SirJuanGod/Matlab-Car-Control-/graphify-out/2026-10-24/GRAPH_REPORT.md

# Graph Report - Car_Control  (2026-10-18)

## Corpus Check
- 13 files · ~40,171 words
- Verdict: corpus is large enough that graph structure adds value.
- Unclassified: 36 file(s) not represented in the graph (top: .mat 26, .l 6, .bak 1)

## Summary
- 67 nodes · 71 edges · 8 communities (6 shown, 2 thin omitted)
- Extraction: 100% EXTRACTED · 0% INFERRED · 0% AMBIGUOUS
- Token cost: 0 input · 0 output

## Community Hubs (Navigation)
- Estrategias de Control: Compuerta (PID, LQR, H-infinita) y Carro Independiente
- 1. Modelo Matemático del Lazo Angular de la Compuerta (canal PWM → θ)
- CLAUDE.md
- Especificaciones del Carro (Plataforma Móvil con IMU y Control Independiente)
- Especificaciones de la Compuerta (Planta Pasiva y Sensor Directo 0-3.3V con ESP32)
- Especificaciones del Ventilador y Etapa de Potencia L298N (24V)
- Arquitectura del Sistema de Control Angular y Plataforma Móvil

## God Nodes (most connected - your core abstractions)
1. `Especificaciones del Carro (Plataforma Móvil con IMU y Control Independiente)` - 9 edges
2. `Estrategias de Control: Compuerta (PID, LQR, H-infinita) y Carro Independiente` - 9 edges
3. `Especificaciones del Ventilador y Etapa de Potencia L298N (24V)` - 8 edges
4. `Arquitectura del Sistema de Control Angular y Plataforma Móvil` - 7 edges
5. `Especificaciones de la Compuerta (Planta Pasiva y Sensor Directo 0-3.3V con ESP32)` - 7 edges
6. `1. Modelo Matemático del Lazo Angular de la Compuerta (canal PWM → θ)` - 5 edges
7. `2. Sensor de Salida: Potenciómetro Directo (0V - 3.3V $\to$ 0° - 180°)` - 4 edges
8. `3. Estrategia 2: Control Óptimo LQR con Acción Integral ($LQR+I$)` - 4 edges
9. `2. Estimación de Distancia Avanzada / Retrocedida con la IMU` - 3 edges
10. `4. Etapa de Potencia: Módulo Puente H L298N a 24 VDC` - 3 edges

## Surprising Connections (you probably didn't know these)
- None detected - all connections are within the same source files.

## Communities (8 total, 2 thin omitted)

### Community 0 - "Estrategias de Control: Compuerta (PID, LQR, H-infinita) y Carro Independiente"
Cohesion: 0.12
Nodes (16): 2.1 Componentes de Implementación, 2. Estrategia 1: Control PID de la Compuerta con Feedforward y Anti-Windup, 3.1 Espacio de Estados Aumentado, 3.2 Optimización Cuadrática, 3.3 Extensión a Dos Salidas del Controlador (SIMO: $u_{PWM}$ y $d_{ref}$), 3. Estrategia 2: Control Óptimo LQR con Acción Integral ($LQR+I$), 4.1 Incertidumbre Paramétrica por Movimiento del Carro, 4.2 Sensibilidad Mixta ($S/KS/T$) (+8 more)

### Community 1 - "1. Modelo Matemático del Lazo Angular de la Compuerta (canal PWM → θ)"
Cohesion: 0.40
Nodes (5): 1.1 Función de Conversión Directa del Potenciómetro, 1.2 Ecuación Dinámica No Lineal, 1.3 Punto de Operación y Equilibrio ($\theta_{eq}$), 1.4 Modelo Linealizado (Pequeña Señal), 1. Modelo Matemático del Lazo Angular de la Compuerta (canal PWM → θ)

### Community 5 - "Especificaciones del Carro (Plataforma Móvil con IMU y Control Independiente)"
Cohesion: 0.18
Nodes (11): 1. Rol en el Proyecto y Condiciones Iniciales, 2.1 Principio Cinemático, 2.2 Observador de Estados / Filtro de Kalman, 2. Estimación de Distancia Avanzada / Retrocedida con la IMU, 3. Parámetros Físicos y Geométricos del Vehículo, 4. Motorreductores DC (Modelo TGP01D-A130), 5. Electrónica del Sistema del Carro, 6. Lazo de Control de Posición Longitudinal del Carro (+3 more)

### Community 6 - "Especificaciones de la Compuerta (Planta Pasiva y Sensor Directo 0-3.3V con ESP32)"
Cohesion: 0.18
Nodes (11): 1. Naturaleza del Sistema Dinámico, 2.1 Calibración Tensión vs. Ángulo (0V a 3.3V), 2.2 Función de Transferencia Directa del Sensor, 2.3 Adquisición Directa con ADC de 12 Bits del ESP32, 2. Sensor de Salida: Potenciómetro Directo (0V - 3.3V $\to$ 0° - 180°), 3. Parámetros Físicos y Mecánicos, 4. Ecuación Dinámica Pasiva de la Compuerta, Enlaces del Grafo (+3 more)

### Community 7 - "Especificaciones del Ventilador y Etapa de Potencia L298N (24V)"
Cohesion: 0.20
Nodes (10): 1. Rol en la Arquitectura de Control, 2. Parámetros de Identificación del Ventilador, 3. Parámetros Eléctricos y Desempeño, 4.1 Configuración de Hardware Crítica del L298N, 4.2 Lógica de Control desde el ESP32, 4. Etapa de Potencia: Módulo Puente H L298N a 24 VDC, 5. Dinámica del Actuador Aerodinámico, Enlaces del Grafo (+2 more)

### Community 8 - "Arquitectura del Sistema de Control Angular y Plataforma Móvil"
Cohesion: 0.29
Nodes (7): 1.1 Estructura SIMO del Controlador (Planta MISO), 1. Descripción General de la Arquitectura, 2. Diagrama de Bloques de los Lazos Internos, 3. Especificaciones Clave de las Interfaces, Arquitectura del Sistema de Control Angular y Plataforma Móvil, Enlaces del Grafo, Etiquetas

## Knowledge Gaps
- **2 thin communities (<3 nodes) omitted from report** — run `graphify query` to explore isolated nodes.

## Suggested Questions
_Questions this graph is uniquely positioned to answer:_

- **Why does `Estrategias de Control: Compuerta (PID, LQR, H-infinita) y Carro Independiente` connect `Estrategias de Control: Compuerta (PID, LQR, H-infinita) y Carro Independiente` to `arquitectura_sistema.md`, `1. Modelo Matemático del Lazo Angular de la Compuerta (canal PWM → θ)`?**
  _High betweenness centrality (0.488) - this node is a cross-community bridge._
- **Should `Estrategias de Control: Compuerta (PID, LQR, H-infinita) y Carro Independiente` be split into smaller, more focused modules?**
  _Cohesion score 0.125 - nodes in this community are weakly interconnected._
- **Why does `Especificaciones del Carro (Plataforma Móvil con IMU y Control Independiente)` connect `Especificaciones del Carro (Plataforma Móvil con IMU y Control Independiente)` to `arquitectura_sistema.md`?**
  _High betweenness centrality (0.271) - this node is a cross-community bridge._
- **Why does `Especificaciones de la Compuerta (Planta Pasiva y Sensor Directo 0-3.3V con ESP32)` connect `Especificaciones de la Compuerta (Planta Pasiva y Sensor Directo 0-3.3V con ESP32)` to `arquitectura_sistema.md`?**
  _High betweenness centrality (0.268) - this node is a cross-community bridge._
