SirJuanGod/Matlab-Car-Control-/code/MATLAB/Outputs/preview/antes_root.png

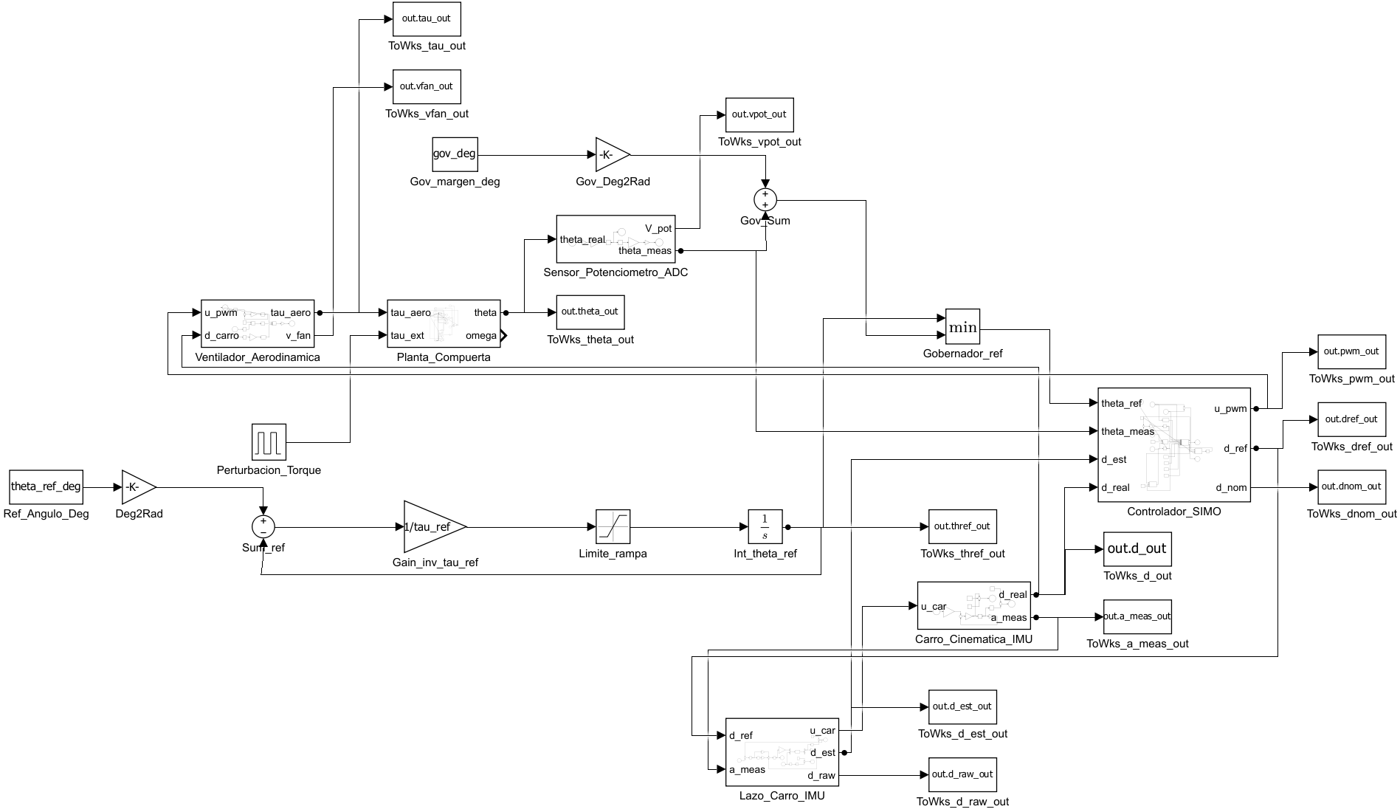
code/MATLAB/Outputs/preview/antes_root.png
