SirJuanGod/Matlab-Car-Control-/code/MATLAB/Outputs/preview/v1_root.png

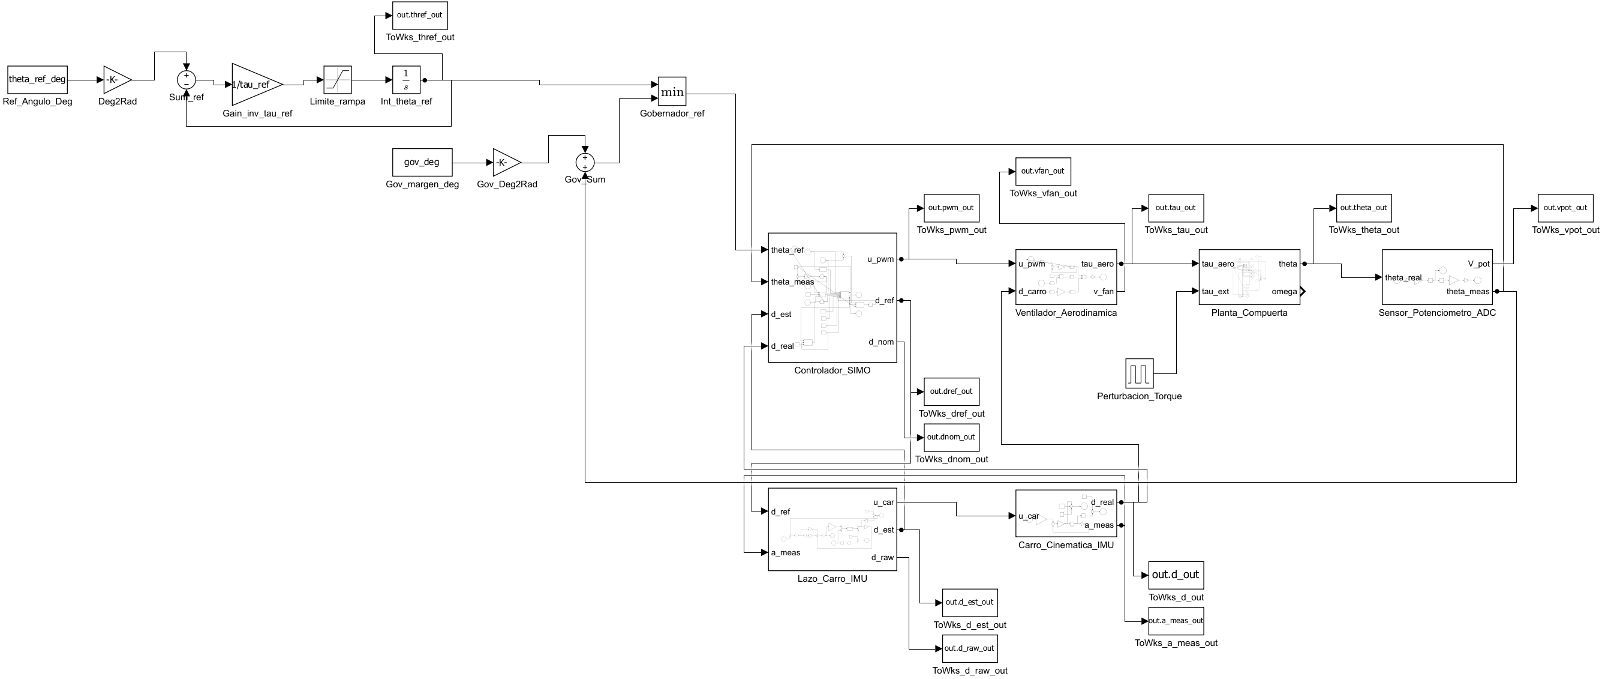
code/MATLAB/Outputs/preview/v1_root.png
