SirJuanGod/Matlab-Car-Control-/code/MATLAB/Outputs/preview/v2_root.png

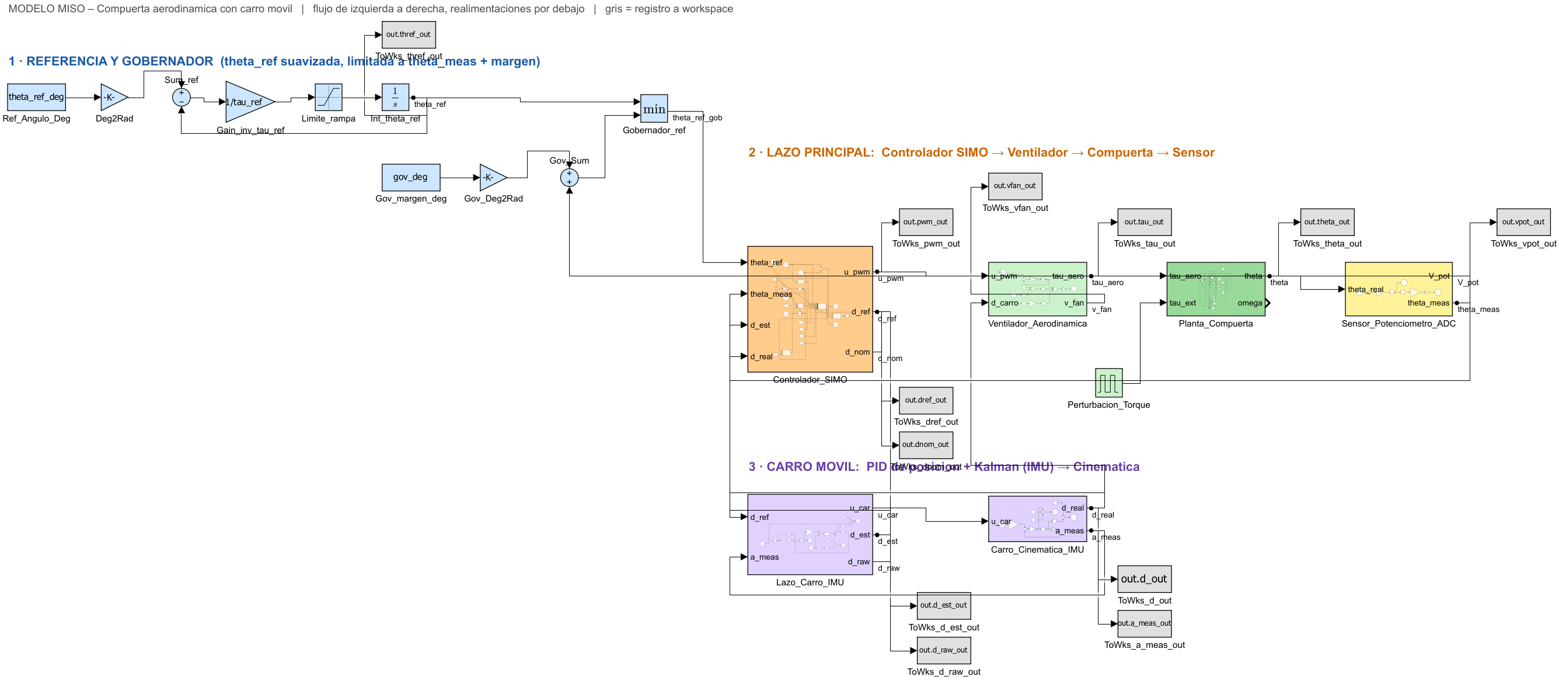
code/MATLAB/Outputs/preview/v2_root.png
