SirJuanGod/Matlab-Car-Control-/outputs/animacion_carro_lejos.gif

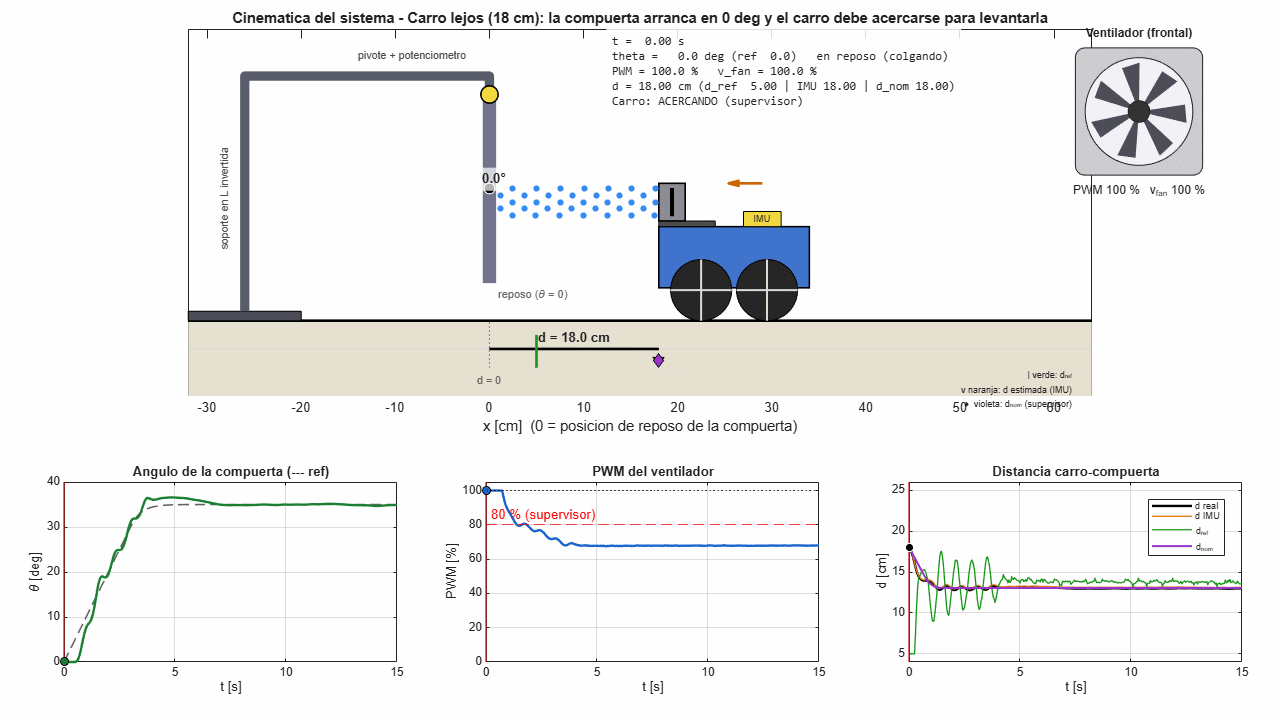
outputs/animacion_carro_lejos.gif
