SirJuanGod/Matlab-Car-Control-/outputs/comparacion_loop_shaping.png

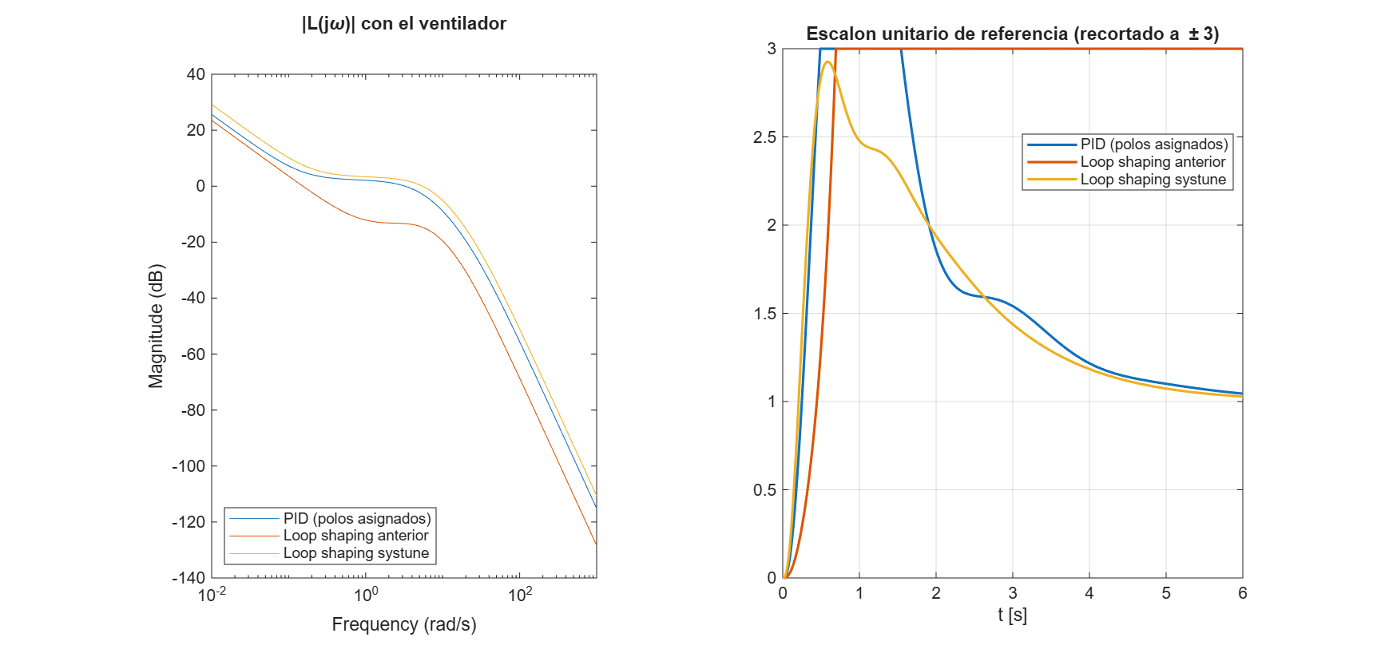
outputs/comparacion_loop_shaping.png
