SirJuanGod/Matlab-Car-Control-/outputs/presentacion/img/f1_nominal.png

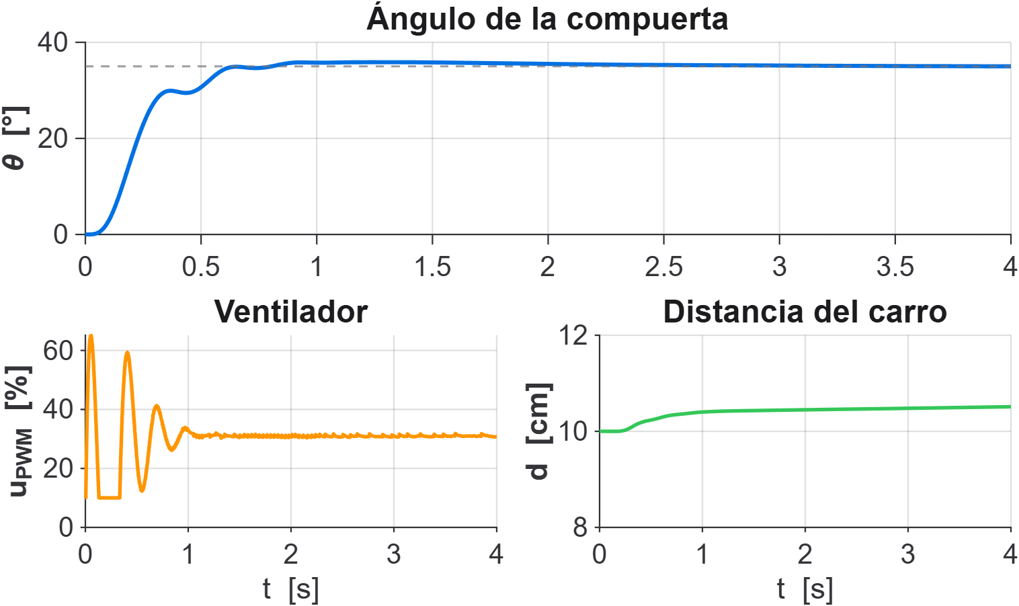
outputs/presentacion/img/f1_nominal.png
