SirJuanGod/Matlab-Car-Control-/outputs/presentacion/img/f2_carro_actua.png

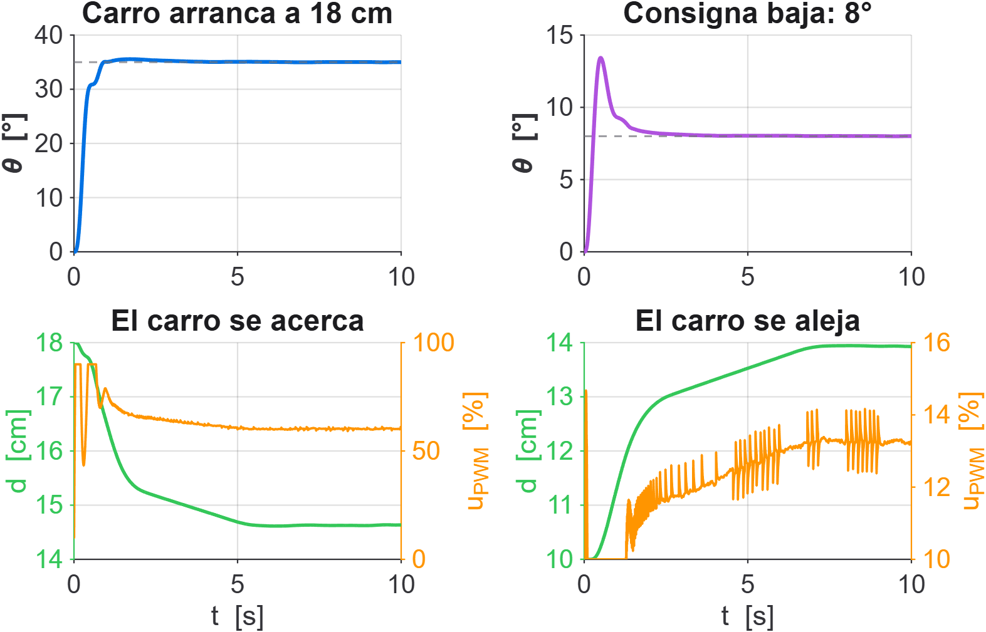
outputs/presentacion/img/f2_carro_actua.png
