SirJuanGod/Matlab-Car-Control-/outputs/presentacion/img/f3_perturbaciones.png

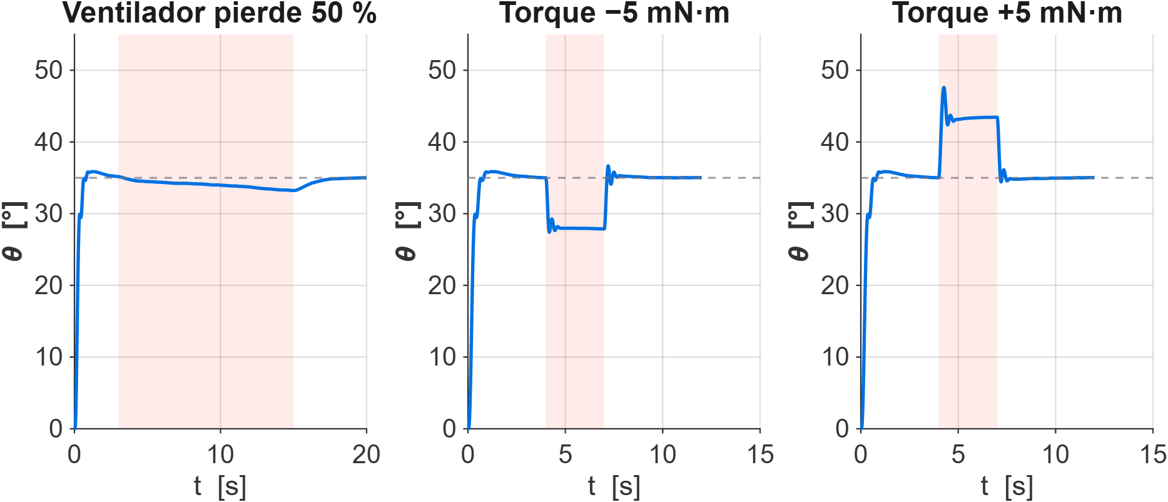
outputs/presentacion/img/f3_perturbaciones.png
