SirJuanGod/Matlab-Car-Control-/outputs/presentacion/img/f4_comparativa.png

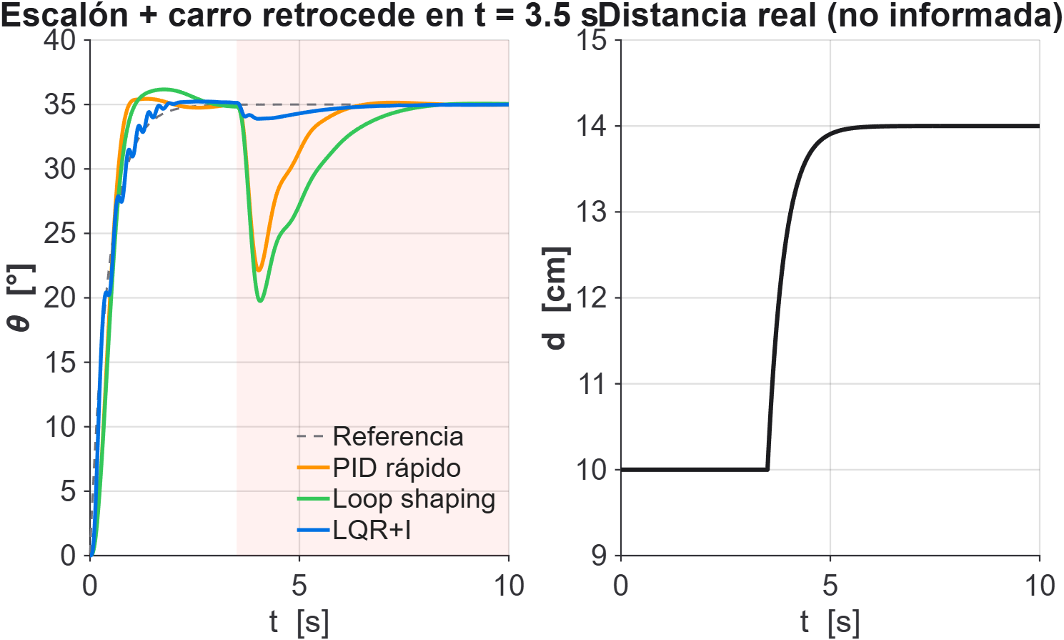
outputs/presentacion/img/f4_comparativa.png
