SirJuanGod/Matlab-Car-Control-/outputs/presentacion/img/f5_polos.png

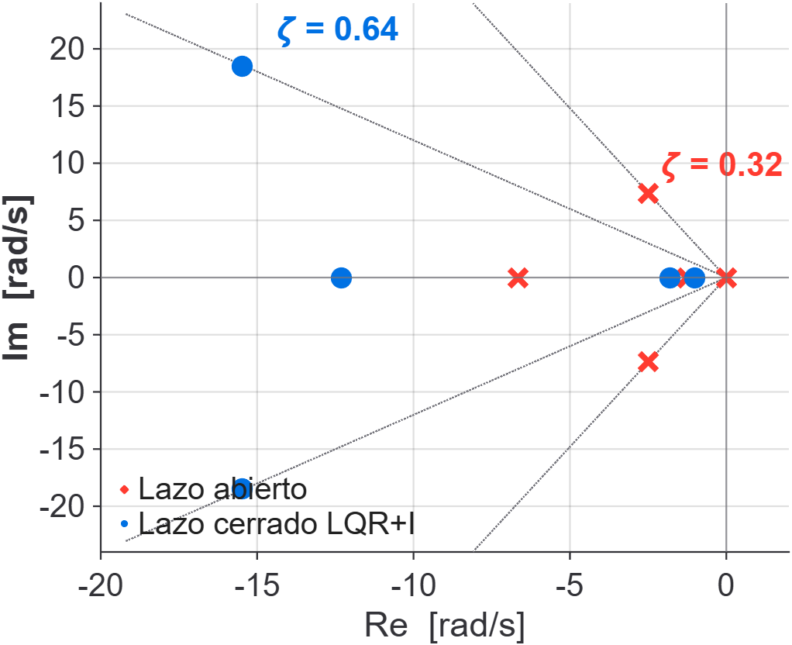
outputs/presentacion/img/f5_polos.png
