SirJuanGod/Matlab-Car-Control-/outputs/presentacion/img/f6_banco.png

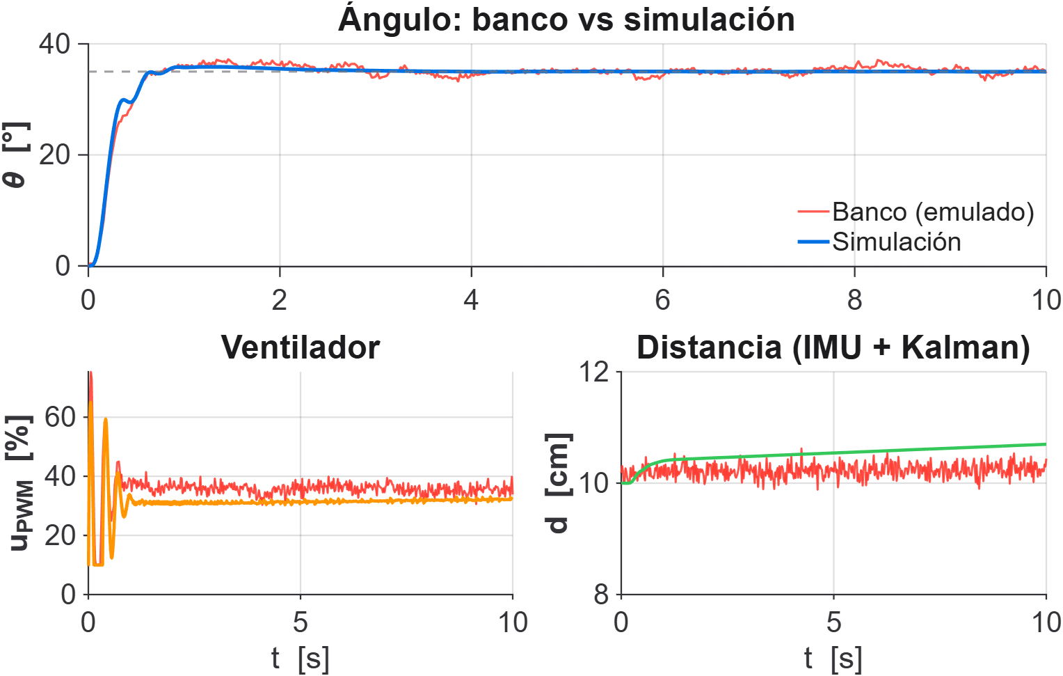
outputs/presentacion/img/f6_banco.png
