SirJuanGod/Matlab-Car-Control-/carro/chasis_base.step

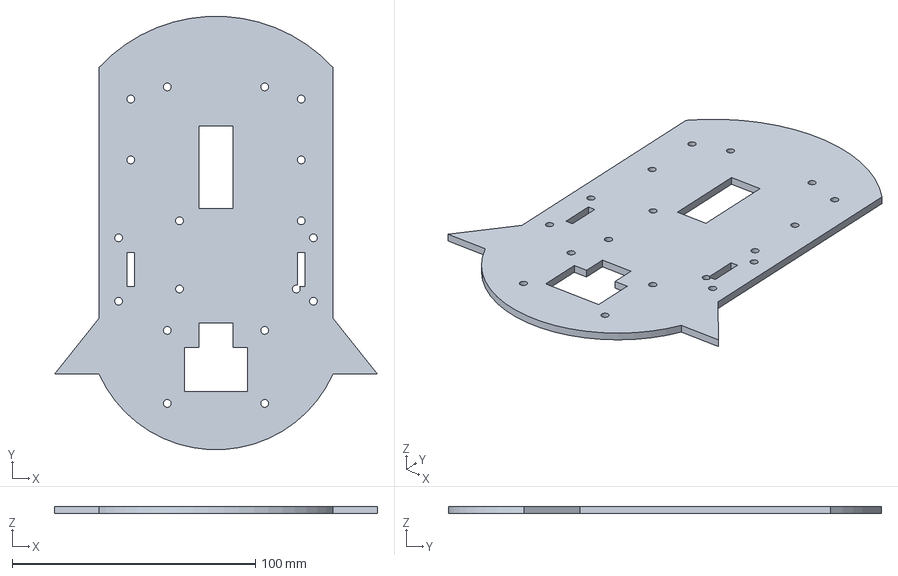
[picture p12: CAD file, 2026-10-22, last stored version]
carro/chasis_base.step
132.7 x 177.8 x 3.00 mm
