SirJuanGod/Matlab-Car-Control-/test/placa_montaje.step

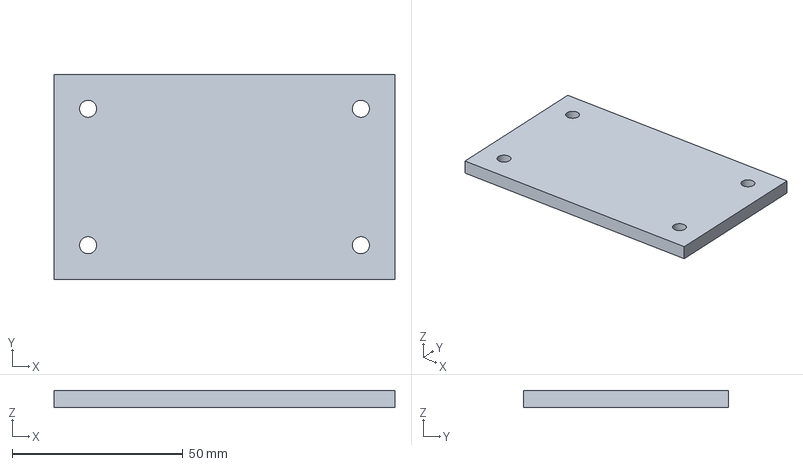
[picture p13: CAD file, 2026-10-22, last stored version]
test/placa_montaje.step
100.0 x 60.0 x 5.00 mm
