SirJuanGod/Matlab-Car-Control-/carro/soporte_vertical.step

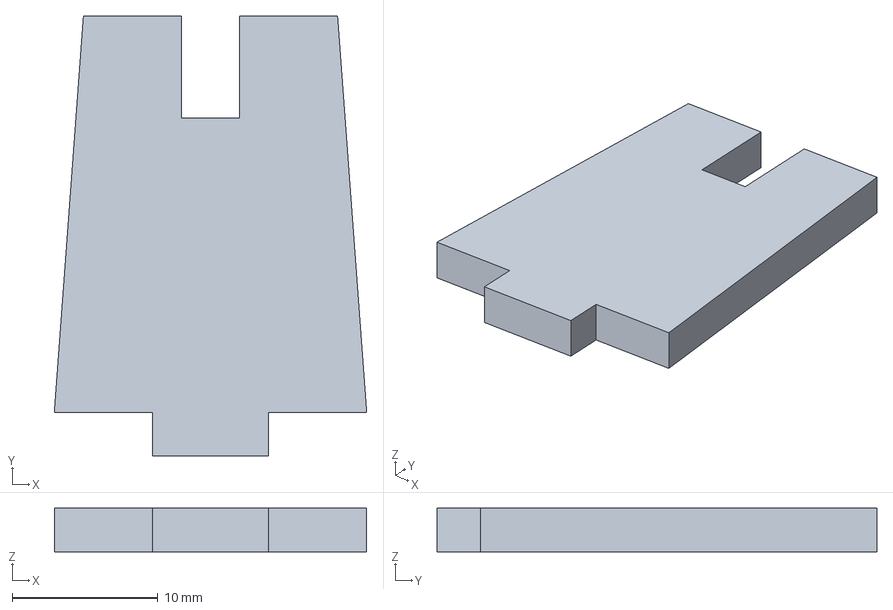
[picture p14: CAD file, 2026-10-22, last stored version]
carro/soporte_vertical.step
21.5 x 30.2 x 3.00 mm
