SirJuanGod/Matlab-Car-Control-/carro/rueda.step

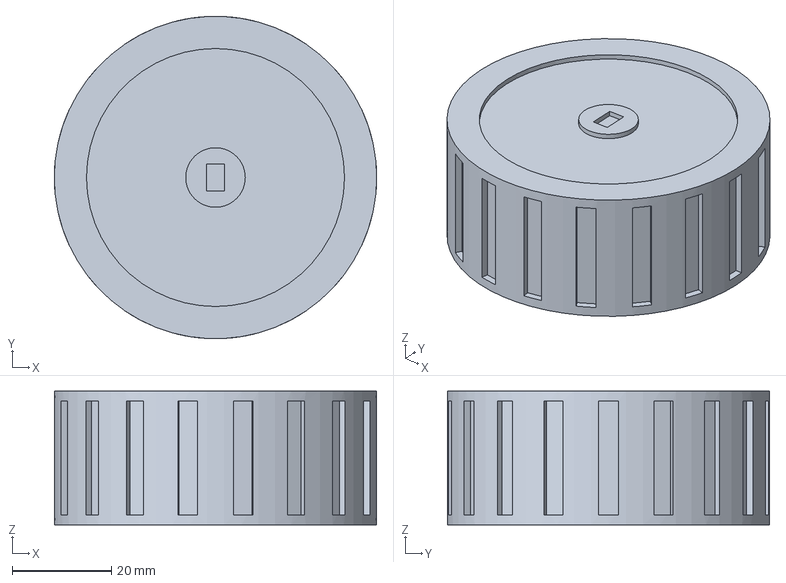
[picture p15: CAD file, 2026-10-22, last stored version]
carro/rueda.step
65.0 x 64.9 x 27.0 mm
