SirJuanGod/Matlab-Car-Control-/carro/soporte_interruptor.step

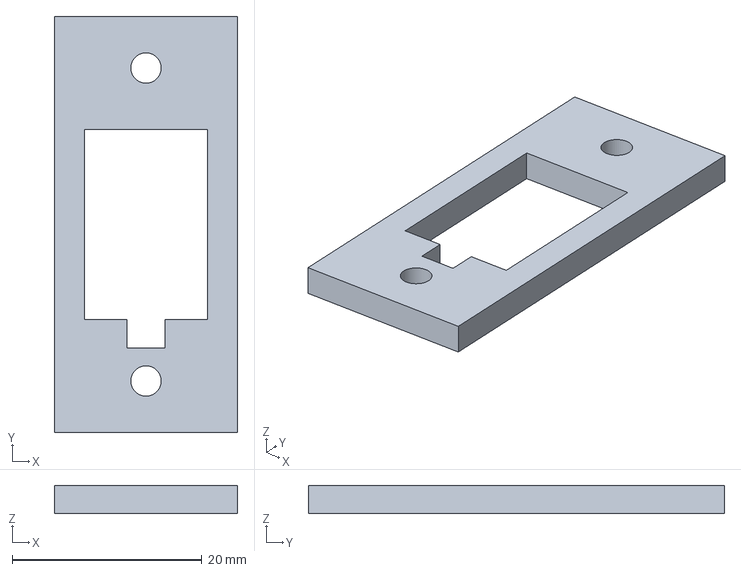
[picture p16: CAD file, 2026-10-22, last stored version]
carro/soporte_interruptor.step
19.3 x 43.9 x 3.00 mm
