SirJuanGod/Matlab-Car-Control-/carro/carro_robot.step

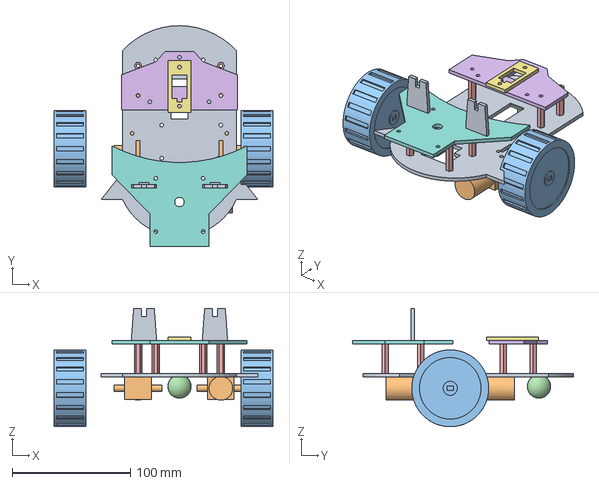
[picture p17: CAD file, 2026-10-22, last stored version]
carro/carro_robot.step
185.1 x 186.5 x 100.1 mm
