SirJuanGod/Matlab-Car-Control-/carro/placa_superior_delantera.step

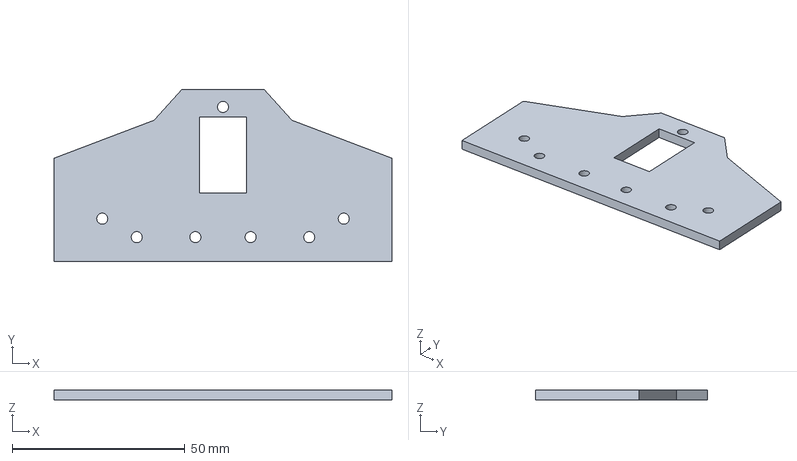
[picture p18: CAD file, 2026-10-22, last stored version]
carro/placa_superior_delantera.step
98.0 x 49.7 x 3.00 mm
