SirJuanGod/Matlab-Car-Control-/carro/rueda_loca.step

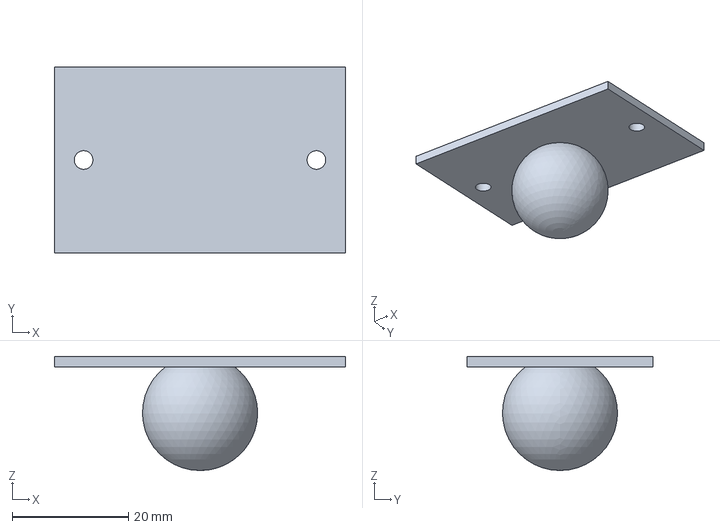
[picture p19: CAD file, 2026-10-22, last stored version]
carro/rueda_loca.step
50.0 x 32.0 x 19.6 mm
