SirJuanGod/Matlab-Car-Control-/carro/motor_tt.step

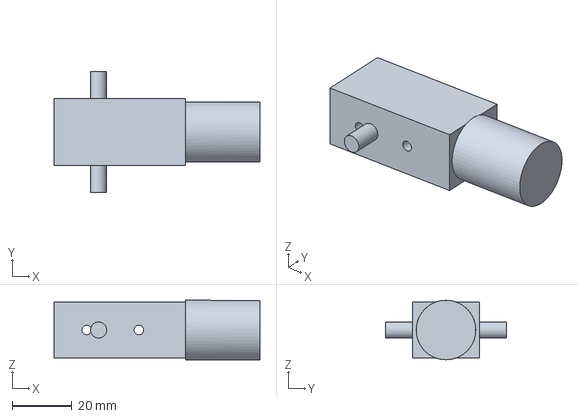
[picture p20: CAD file, 2026-10-22, last stored version]
carro/motor_tt.step
69.2 x 40.5 x 20.0 mm
