SirJuanGod/Matlab-Car-Control-/carro/placa_superior_trasera.step

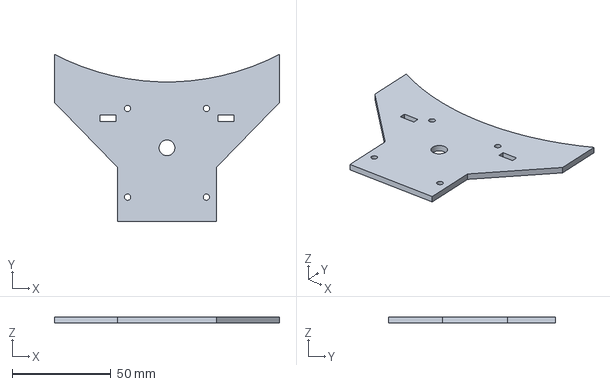
[picture p21: CAD file, 2026-10-22, last stored version]
carro/placa_superior_trasera.step
114.2 x 84.9 x 3.00 mm
