SirJuanGod/Matlab-Car-Control-/(list of files, cad)

Other CAD files:
carro/carro_robot.FCStd
test/placa_montaje.FCStd
