SirJuanGod/Matlab-Car-Control-/code/C/esp32_carro_control/main/lqr_tablas.h

// Generado por code/MATLAB/exportar_lqr_c.m desde init_parametros.m: no editar a mano.
#ifndef LQR_TABLAS_H
#define LQR_TABLAS_H

#define LQR_D0_M         0.100000000f  // distancia de referencia aerodinamica [m]
#define LQR_K_M          0.000300000000f  // ganancia aerodinamica en d0 [N*m/%]
#define LQR_MGL          0.0147150000f  // m_g*g*l_c [N*m]
#define LQR_D_MIN_M      0.0500000000f  // limite de distancia [m]
#define LQR_D_MAX_M      0.250000000f  // limite de distancia [m]
#define LQR_D_INI_M      0.100000000f  // distancia inicial y de regreso del supervisor [m]
#define LQR_PWM_MIN      10.0000000f  // saturacion del PWM [%]
#define LQR_PWM_MAX      90.0000000f  // saturacion del PWM [%]
#define LQR_XI_BAND_RAD  0.0872664626f  // la integral solo acumula con |e| menor que esto [rad]
#define LQR_XI_LIM       2.00000000f  // limite de la integral del error [rad*s]
#define LQR_TAU_W        0.0400000000f  // filtro de la derivada que estima omega [s]
#define LQR_TAU_FAN      0.150000000f  // modelo del ventilador para estimar v_fan [s]
#define LQR_TAU_REF      0.150000000f  // prefiltro de la referencia [s]
#define LQR_REF_RATE     3.49065850f  // limite de rampa de la referencia [rad/s]
#define LQR_GOV_RAD      1.57079633f  // gobernador: theta_ref <= theta_meas + esto [rad]
#define LQR_SUP_V_HI     70.0000000f  // supervisor: acerca el carro si p_raw supera esto [%]
#define LQR_SUP_V_LO     20.0000000f  // supervisor: regresa hacia d_ini si p_raw baja de esto [%]
#define LQR_SUP_ADV      0.0500000000f  // supervisor: velocidad maxima de d_nom [m/s]
#define LQR_SUP_RET      0.0100000000f  // supervisor: velocidad de regreso de d_nom [m/s]

#define LQR_N_TH 15  // rejilla de scheduling en theta_ref
#define LQR_N_D  9  // rejilla de scheduling en d_nom

static const float LQR_THG_DEG[LQR_N_TH] = {10.0000000f, 15.0000000f, 20.0000000f, 25.0000000f, 30.0000000f, 35.0000000f, 40.0000000f, 45.0000000f, 50.0000000f, 55.0000000f, 60.0000000f, 65.0000000f, 70.0000000f, 75.0000000f, 80.0000000f};
static const float LQR_DG_CM[LQR_N_D] = {5.00000000f, 7.50000000f, 10.0000000f, 12.5000000f, 15.0000000f, 17.5000000f, 20.0000000f, 22.5000000f, 25.0000000f};

// Fila (j*LQR_N_TH + i) <-> (theta_i, d_j); K(2x5) por columnas: K[r][c] = fila[c*2 + r]
static const float LQR_KG[LQR_N_TH * LQR_N_D][10] = {
    {648.006385f, -2.07570712f, 66.6109633f, -0.215738151f, 9.99275936f, -0.0343440335f, -9.15840893f, 0.259566137f, 706.911288f, -2.35130349f},
    {650.331658f, -3.10524024f, 66.6252006f, -0.321626504f, 9.99065165f, -0.0511736890f, -13.6463171f, 0.302040720f, 706.673409f, -3.50055326f},
    {653.566813f, -4.12450286f, 66.6456976f, -0.425157142f, 9.98789268f, -0.0675973692f, -18.0259651f, 0.359583148f, 706.352189f, -4.61862643f},
    {657.691882f, -5.12960788f, 66.6729884f, -0.525575492f, 9.98466523f, -0.0834876115f, -22.2633631f, 0.430362298f, 705.958791f, -5.69593857f},
    {662.681541f, -6.11629625f, 66.7077168f, -0.622152705f, 9.98119193f, -0.0987232504f, -26.3262001f, 0.512146502f, 705.506701f, -6.72353319f},
    {668.505338f, -7.07987482f, 66.7506066f, -0.714190791f, 9.97772688f, -0.113190490f, -30.1841307f, 0.602384192f, 705.011175f, -7.69317010f},
    {675.127927f, -8.01517328f, 66.8024281f, -0.801027035f, 9.97454624f, -0.126783714f, -33.8089904f, 0.698291957f, 704.488645f, -8.59738271f},
    {682.509307f, -8.91652213f, 66.8639609f, -0.882037690f, 9.97193818f, -0.139406035f, -37.1749428f, 0.796945976f, 703.956120f, -9.42950832f},
    {690.605038f, -9.77775351f, 66.9359553f, -0.956640980f, 9.97019273f, -0.150969606f, -40.2585617f, 0.895373309f, 703.430605f, -10.1836967f},
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
    {604.423231f, -17.3021218f, 73.7019182f, -2.17028381f, 4.74451560f, -0.152735306f, -40.7294148f, 1.73221382f, 690.910838f, -21.2801380f},
    {621.684171f, -19.0637798f, 73.9904168f, -2.33045053f, 4.74163344f, -0.163054162f, -43.4811098f, 1.93823082f, 688.978719f, -22.4981443f},
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
};

#endif // LQR_TABLAS_H
