SirJuanGod/Matlab-Car-Control-/code/C/esp32_base_potenciometro/main/adc_reader.h

#ifndef ADC_READER_H
#define ADC_READER_H

#include <stdint.h>
#include <stdbool.h>
#include "esp_err.h"

#define POT_ADC_CHANNEL        ADC_CHANNEL_6 // GPIO34 en ESP32 ADC1
#define ADC_MAX_COUNTS         4095.0f
#define ANGLE_MAX_DEG          180.0f
#define ADC_SAMPLING_PERIOD_US 10000 // 10 ms = 100 Hz

// Filtrado del angulo
#define ADC_OVERSAMPLES        16     // Lecturas promediadas por cada periodo de muestreo
#define ANGLE_KF_R             0.05f  // Varianza de la medicion promediada [deg^2]
#define ANGLE_KF_Q_ACCEL       2000.0f // Densidad de aceleracion angular [deg^2/s^3]: mas alto = sigue mas rapido, filtra menos

/**
 * @brief Inicializa el periferico ADC1 en GPIO34 y configura el muestreo periodico no bloqueante.
 *        La lectura filtrada se consulta con adc_reader_get_last_angle().
 * 
 * @return esp_err_t ESP_OK si la inicializacion fue exitosa.
 */
esp_err_t adc_reader_init(void);

/**
 * @brief Inicia el temporizador de muestreo no bloqueante del ADC.
 */
esp_err_t adc_reader_start(void);

/**
 * @brief Detiene el temporizador de muestreo.
 */
esp_err_t adc_reader_stop(void);

/**
 * @brief Obtiene la ultima lectura angular calculada [0.0 - 180.0 deg].
 */
float adc_reader_get_last_angle(void);

#endif // ADC_READER_H
