SirJuanGod/Matlab-Car-Control-/code/C/esp32_carro_control/main/mpu6050.h

#ifndef MPU6050_H
#define MPU6050_H

#include <stdint.h>
#include <stdbool.h>
#include "esp_err.h"

#define MPU6050_I2C_PORT       I2C_NUM_0
#define MPU6050_I2C_SDA_PIN    21
#define MPU6050_I2C_SCL_PIN    22
#define MPU6050_I2C_FREQ_HZ    400000
#define MPU6050_ADDR           0x68

// Acondicionamiento de la aceleracion longitudinal (lectura a 100 Hz desde main.c)
#define IMU_ACCEL_LPF_ALPHA    0.3f   // Pasa-bajas de 1er orden: fc ~ 5.7 Hz a 100 Hz
#define IMU_ACCEL_DEADBAND     0.08f  // [m/s^2] por debajo se considera reposo (ruido/vibracion)

/**
 * @brief Inicializa el puerto I2C y despierta/configura el sensor MPU6050 (rango +-2g).
 * 
 * @return esp_err_t ESP_OK si el sensor respondio correctamente en el bus.
 */
esp_err_t mpu6050_init(void);

/**
 * @brief Ejecuta una calibracion rapida en reposo para hallar el sesgo inicial de aceleracion.
 * 
 * @param samples_count Numero de muestras para promediar el cero (ej. 100).
 * @return esp_err_t ESP_OK en caso de exito.
 */
esp_err_t mpu6050_calibrate_bias(uint16_t samples_count);

/**
 * @brief Lee la aceleracion instantanea en el eje longitudinal X [m/s^2].
 * 
 * @param out_ax Puntero donde se almacenara la aceleracion compensada con el sesgo.
 * @return esp_err_t ESP_OK si la lectura I2C fue exitosa.
 */
esp_err_t mpu6050_read_accel_x(float *out_ax);

/**
 * @brief Lee la velocidad angular de giro del frente (eje Z) compensada con el sesgo de reposo.
 *
 * @param out_gz_dps Velocidad angular [deg/s].
 * @return esp_err_t ESP_OK si la lectura I2C fue exitosa.
 */
esp_err_t mpu6050_read_gyro_z(float *out_gz_dps);

/**
 * @brief Indica si el sensor esta operativo y calibrado.
 */
bool mpu6050_is_ready(void);

#endif // MPU6050_H
