SirJuanGod/Matlab-Car-Control-/(commit log)

2026-10-22 Setup the matlab Car control
    [carro_robot.FCStd, carro_robot.step, chasis_base.step, motor_tt.step, placa_montaje.FCStd, placa_montaje.step, placa_superior_delantera.step, placa_superior_trasera.step]
2026-10-23 Reduce Code comments
    [placa_montaje.FCStd, placa_montaje.step]
2026-10-26 Setup control module to the matlab Car control
    [carro_robot.FCStd, carro_robot.step, chasis_base.step, motor_tt.step, placa_montaje.FCStd, placa_montaje.step, placa_superior_delantera.step, placa_superior_trasera.step]
2026-10-26 Setup c code to esp-idf Car control and fix simulation to MATLAB
    [adc_reader.c, adc_reader.h, car_controller.c, car_controller.h, espnow_base.c, espnow_base.h, espnow_car.c, espnow_car.h]
2026-10-26 Fix C firmware audit findings 1-11
    - Base UART: clamp snprintf length (stack over-read), require full
    6-field $CMD with finite values (no re-enabling actuators, no NaN)
    - Base: zero car telemetry after 500 ms without packets, silence logs on
    shared UART0, drop redundant ADC queue
    - ESP-NOW: configurable peer MACs with source filtering, print own MAC;
    drop dead pre-IDF-5.0 callback branches
    - Car: feed the observer the applied motor effort, reset integrators
    while an actuator is disabled, keep motors off without IMU
    - Add host test for controller and observer; document in README
    Claude-Session: https://claude.ai/code/session_012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
    [adc_reader.c, adc_reader.h, car_controller.c, car_controller.h, espnow_base.c, espnow_car.c, main.c, protocol_defs.h]
2026-10-26 Add MATLAB UART reader for base station telemetry
    uart_esp32.m opens the serial port, sends the $CMD setpoint (resent
    every second in case opening the port resets the board), parses $TEL
    lines with a live plot, returns the data as a struct, and sends a
    motors/fan-off command on exit or Ctrl+C.
    Claude-Session: https://claude.ai/code/session_012EFg96yEumjcvuKr5EUYLo
2026-10-27 Resolve merge conflict markers in MATLAB scripts
    Keep HEAD's controller design block (PID by root locus, LQR+I gain
    scheduling, loop shaping) in init_parametros.m and origin/main values
    elsewhere. Restore zeta_des, wn_des and p_int, lost in the merge and
    required by the PID design block.
2026-10-27 Set distance supervisor thresholds to estrategias_control.md values
    sup_v_hi=70 %, sup_v_lo=20 %, sup_ret=1 cm/s, also as the GUI default.
    Verified in modelo_miso_compuerta.slx: car starting at 20 cm settles
    at 14.6 cm; 0->35 deg step keeps rise 0.41 s, overshoot 0.86 deg,
    settling 0.59 s; theta_ref=8 deg moves the car to 13.9 cm.
2026-10-27 Add MATLAB GUI linking the base station firmware to the user
    gui_esp32 opens the serial port, sends $CMD (actuators start off,
    resent every second), and plots $TEL live: theta vs reference, the PWM
    sent to the fan with min/max and a saturation flag, IMU distance vs
    d_ref and car effort. Flags a silent base and a car without ESP-NOW
    link; on close it stops the actuators and saves datos_esp32.
    test_gui_esp32 checks parsing, indicators and the $CMD format without
    hardware.
2026-10-27 Show steady-state error in the GUIs and fix README equations
    - init_parametros: restore the controller design block that the README
    documents (ITAE-tuned PID Kp=10.70, Ki=128.8, Kd=1.65; loop shaping
    K=2.875), replacing the outdated pole-placement block kept in the
    merge that gave negative gains. The car PID zeros printed in the
    banner no longer get overwritten by the gate PID zeros.
    - gui_esp32: steady-state error of theta and d, averaged over the last
    1 s once the setpoint has been still for 2 s; with a test.
    - gui_simulacion: steady-state error in the run summary.
    - README: car PID transfer function numerator (derivative acts on v,
    not on the error), d_ref saturation units, 90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
2026-10-27 Split crowded README equations and show calculations step by step
    Each relation gets its own line instead of sharing one with \qquad;
    matrices get row spacing; v_eq, theta_min, g_d, every term of A, the
    car PID gains in newtons and the static gains are now worked out with
    numbers. Long table cells and paragraphs become lists or small tables.
2026-10-27 Add ESP32 setup and flashing guide to README
    New section 8: wiring for both boards, the sdkconfig settings, how to
    install and activate ESP-IDF v6.1, find the COM ports, build and flash
    each project, start the system from gui_esp32, and common problems.
    Each command sits in its own block so GitHub shows a copy button.
2026-10-29 Run the LQR+I SIMO on the car ESP32; GUI only reads and sends setpoints
    - lqr_simo.c ports the Controlador_SIMO block of modelo_miso_compuerta.slx
    (reference prefilter and governor, omega and v_fan estimators, 2-D
    gain scheduling, anti-windup, distance supervisor); the 135 gains come
    from lqr_tablas.h, generated by exportar_lqr_c.m from init_parametros.m.
    - The car computes d_ref itself; the MATLAB HIL mode and the d_ref and
    PWM fields are gone from the protocol: $CMD,<theta_ref>,<en_m>,<en_f>.
    - The base starts with the actuators off, sends theta at 100 Hz and no
    longer low-pass filters it (~30 ms of lag the design does not have).
    - gui_esp32 sends nothing until the user acts, sho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
2026-10-29 Run the controller test on an emulated ESP32 with QEMU
    code/C/test is a minimal ESP-IDF project that builds test_control.c with
    the car controller, so the closed-loop LQR test runs without a host gcc:
    idf.py -C code/C/test qemu. In QEMU it passes with the same numbers as
    the MATLAB translation (35 deg: t90 0.31 s, overshoot 2.52 deg).
    [test_control.c]
2026-11-04 Read the car IMU with tilt, scale and noise compensation
    The car carries an MPU9250 (WHO_AM_I 0x71), not an MPU6050, so the
    driver now accepts the whole MPU6050/6500/9250/9255 family and scans
    the I2C bus at boot. Calibration reads all three axes to remove the
    fixed tilt of the mount (about -11 deg) and to correct the ~10 % gain
    error of the accelerometer. The longitudinal acceleration goes through
    a low-pass filter and a soft deadband so only real motion reaches the
    observer. The gyro Z axis is calibrated and exposed for heading control.
    [mpu6050.c, mpu6050.h]
2026-11-04 Drive the car motors at 80-100 % PWM with differential steering
    The geared motors only overcome static friction from about 80 % duty,
    so the traction command maps to 80-100 %. Each wheel can now get its
    own duty so the heading controller can compensate the drift caused by
    the caster wheel. MOTOR_DIR_INVERT flips both bridges because the
    direction test showed IN1/IN3 high moves the car away from the gate.
    [motor_fan_pwm.c, motor_fan_pwm.h]
2026-11-04 Stop spurious car motion and keep the car heading straight
    - Distance deadband grows to 1 cm, the integral freezes inside it and
    the motors switch on at |u| >= 8 % and off below 4 % (hysteresis), so
    IMU noise no longer kicks the car to 80 % PWM.
    - The observer receives the PWM really applied (80-100 %), not u_car.
    - The distance estimate resets to d0 each time the motors are enabled.
    - A gyro-Z PD keeps the heading while driving, with stronger gains in
    reverse where the caster wheel is unstable.
    - When the gate is stalled the LQR integral accumulates the full error,
    so the fan keeps rising until the gate moves or the PWM saturates.
    - LED on GPIO2 blinks three times after a clean boot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
    [car_controller.c, lqr_simo.c, main.c, status_led.c, status_led.h]
2026-11-04 Pair base and car over ESP-NOW channel 8
    Both nodes use channel 8 and the real STA MACs of the boards
    (base 78:1C:3C:A7:C3:7C, car D0:EF:76:33:88:24) instead of broadcast,
    so each one only accepts packets from its peer.
2026-11-04 Filter the gate angle at the base with oversampling and a Kalman filter
    Each 10 ms sample averages 16 ADC reads and feeds a two-state
    (angle, angular rate) constant-velocity Kalman filter, which follows
    ramps without the lag of a plain low-pass. With the pot still, the
    standard deviation dropped from 0.51 deg to 0.14 deg.
2026-11-04 Smooth the live plots of the ESP32 GUI
    Plots and indicators show an exponential average (tau 0.3 s) drawn at
    25 Hz; saturation, min/max, steady-state error and the saved
    datos_esp32 keep using the raw telemetry.
2026-11-04 Add a bench test project for the car motors
    esp32_prueba_motores has a PWM sweep (TEST_MODE 0) to find the duty at
    which the wheels start, and a direction test (TEST_MODE 1) that pulses
    forward and reverse as the car firmware does, with the LED on during
    the forward pulse and the IMU measuring the resulting motion.
    [main.c]
2026-11-05 Drive the 12 V PC fan with a 25 Hz PWM on its own timer
    The new DS07015R12 fan (3-wire, 12 V 0.20 A) whines at 5 kHz and its
    internal electronics misbehave with fast chopping. Measured with the
    tachometer, 25 Hz gives a clean monotonic response (90 % duty reaches
    ~98 % of the full-speed RPM) and no audible tone. The fan moves to
    LEDC timer 1 so the traction motors keep their 5 kHz PWM.
2026-11-05 Add fan sweep and PWM frequency comparison to the motor bench test
    TEST_MODE 2 sweeps the fan through the range configured in the car
    firmware (FAN_PWM_MIN/MAX_PERCENT) without needing the base.
    TEST_MODE 3 compares 25 Hz, 5 kHz and 25 kHz at several duties and
    reads the RPM from the tachometer on GPIO4; readings above the
    full-speed value are discarded as PWM noise coupled into the tach line.
    [main.c]
2026-11-05 Fix the specs: close the mermaid blocks and use the 0-1.65 V pot range
    The gate works over 0-90 deg, which is 0-1.65 V on the 3.3 V pot, so the
    diagrams and the ADC formula now say so. Also renumbers the sections of
    estrategias_control.md, matches the car error sign to the code, and aligns
    comments in init_parametros.m and gui_simulacion.m.
